frahz/SeaBug/README.md

# Seabug

The SEABUG underwater Retrieval System is an acoustic release system with a buoy and transponders that allow retrieval and instrument packages from the seafloor without the need for divers.
