frahz/SeaBug/docs/hardware.md

# Hardware

This document file will contain some information regarding the housing prototype that was used for this project.

In the `assets` folder there is a fusion 3d file that was used to make a 3D model of the housing.

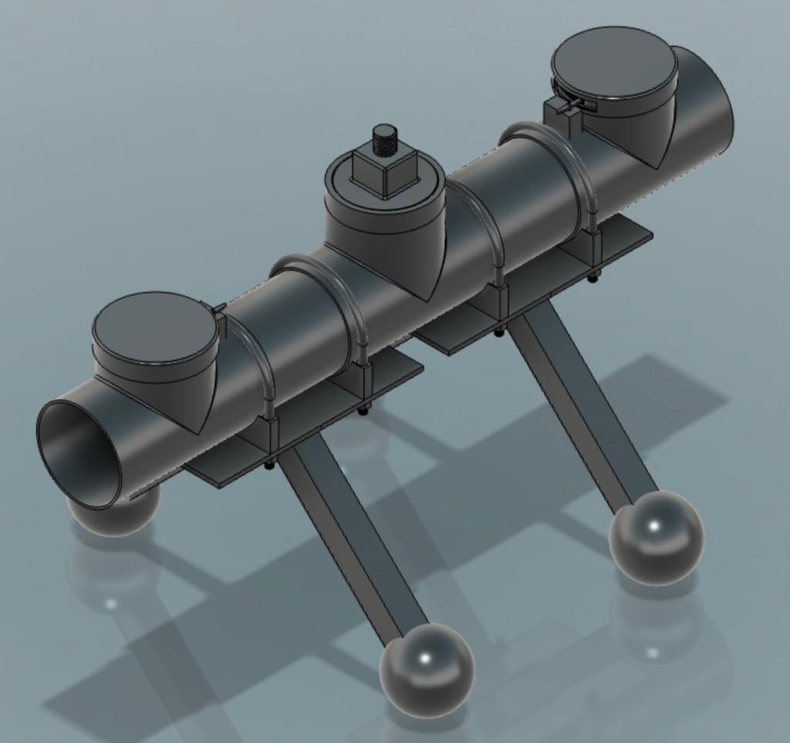
[picture p3: assets/housing.jpg]


Above we see the 3D model of the housing and on the picture below we see it fully assembled.

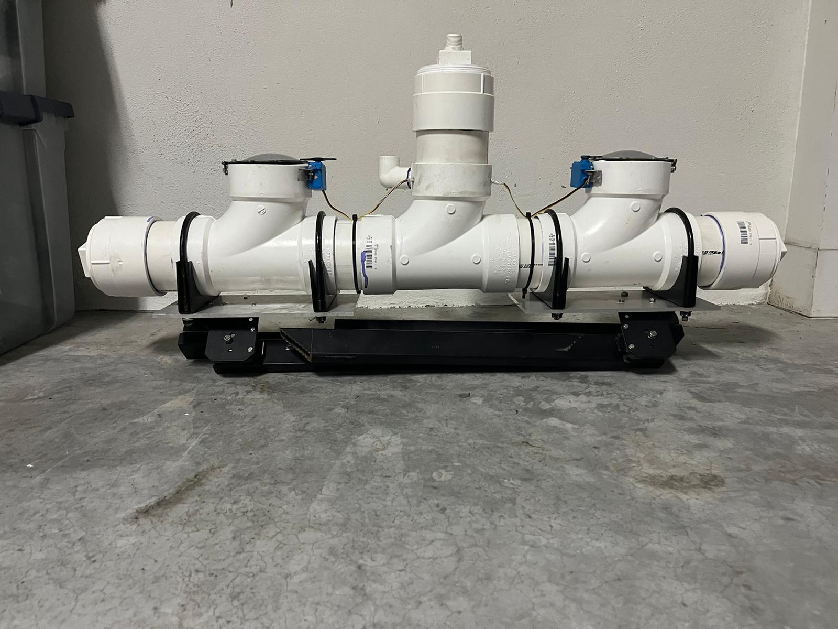
[picture p4: assets/housing_irl.jpg]


## Components

The following is a list of the some of the components, and links for where to get them used to build the housing:

-   [4 in. x 4 in. PVC DWV Saddle Tee (2)](https://www.homedepot.com/p/4-in-x-4-in-PVC-DWV-Saddle-Tee-Only-S26017/320234067)
-   [4 in. x 2 ft. PVC Schedule 40 DWV (2)](https://www.homedepot.com/p/Charlotte-Pipe-4-in-x-2-ft-PVC-Schedule-40-DWV-Foam-Core-Pipe-PVC-04400-0200/202018044)
-   [4 in. DWV PVC Sanitary Tee (4)](https://www.homedepot.com/p/Charlotte-Pipe-4-in-DWV-PVC-Sanitary-Tee-PVC004001400HD/203394133#overlay)
-   [PVC 4” Cleanout with Plug (3)](https://www.amazon.com/dp/B00MH5ENOU/?coliid=IB589JC9RLVAO&colid=OVFXFWCL6PIH&psc=1&ref_=lv_ov_lig_dp_it)
-   [5” Stainless Steel Saddle U-Bolt Clamp (4)](https://www.amazon.com/dp/B07BJZYQFB/?coliid=I9P884SMVT7UN&colid=OVFXFWCL6PIH&ref_=lv_ov_lig_dp_it&th=1)
-   [Foldable Support Bracket-Self-Locking Hinge (2)](https://www.amazon.com/MechWares-Foldable-Bracket-Self-Locking-Workbench-Extension/dp/B07BHKB6CN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)
-   [Steel Rectangular Tube, 1" Height X 2" Width 4 feet (2)](https://www.amazon.com/Unpolished-1008-1010-Rectangular-Height-Thickness/dp/B007WLWQDE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)
-   Bolts
-   Brackets
-   Sheet Metal
-   PVC Glue
-   Teflon Tape

## Assembly

For the assembly of the housing, TODO.
