frahz/SeaBug/(list of files, cad)

Other CAD files:
assets/SEABUG Underwater Release System.f3d
