frahz/SeaBug/(list of files, drawings)

Other design files:
assets/receiver.fzz
