frahz/SeaBug/(commit log)

2022-02-28 add Servo motor functionality
2022-03-07 update servo position
2022-03-26 add 2nd servo motor code and some additional comments
2022-05-21 add all assets/images to the project folder
    [SEABUG Underwater Release System.f3d, reciever.fzz]
2022-05-21 correct typo
    [receiver.fzz, reciever.fzz]
2022-05-21 add documentation for the circuits
